Chiraggalav0024/moveo-robotic-arm/gallery/1.jpeg

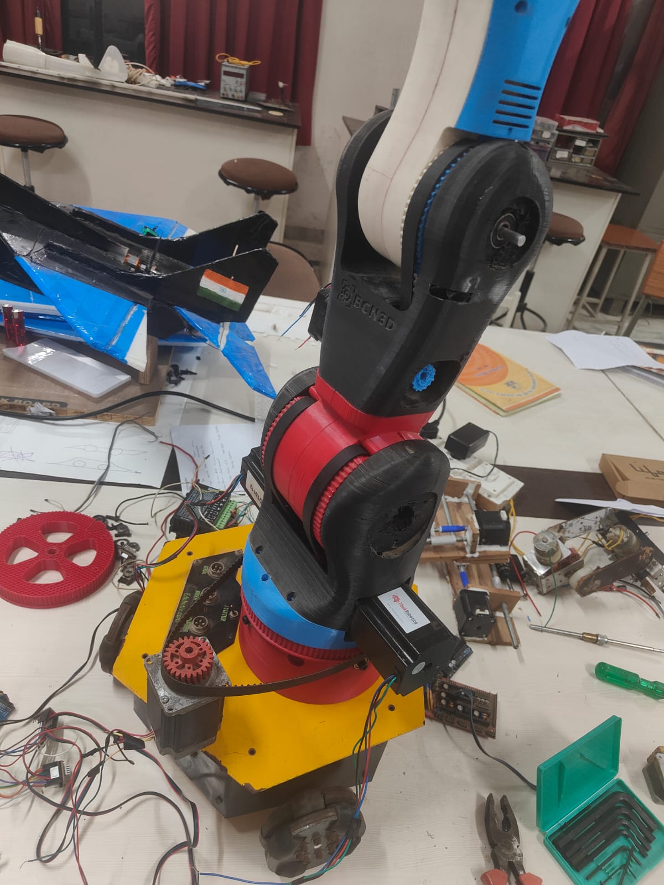
gallery/1.jpeg
