Chiraggalav0024/moveo-robotic-arm/gallery/2.jpeg

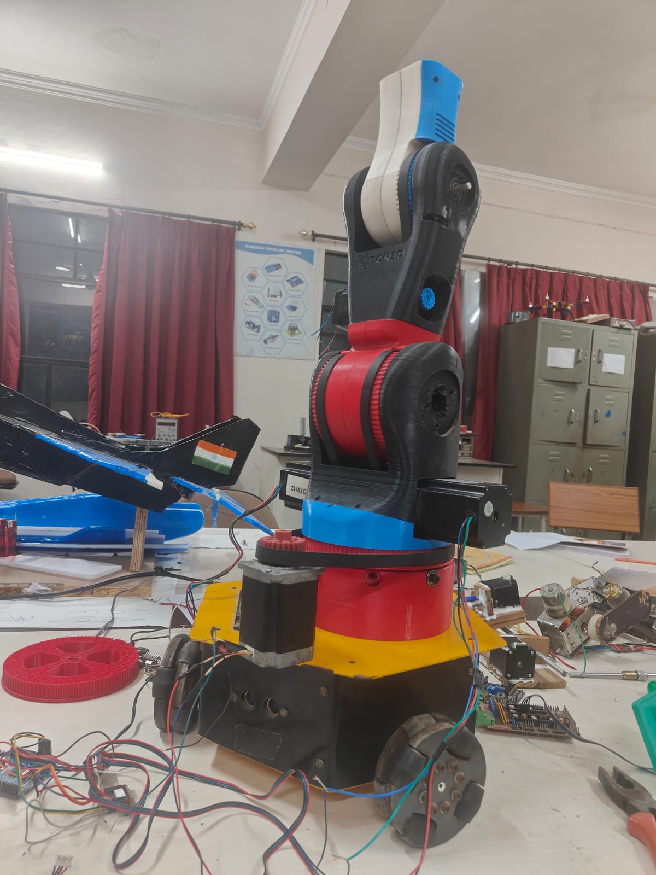
gallery/2.jpeg
