Chiraggalav0024/moveo-robotic-arm/README.md

# moveo-robotic-arm
A detailed report for this project is available as a PDF — it covers hardware assembly, wiring, firmware upload steps, controller and pairing setup.

📄 **[View Full Manual (PDF)](https://github.com/Chiraggalav0024/moveo-robotic-arm/blob/main/report.pdf)**
