Chiraggalav0024/moveo-robotic-arm/(commit log)

2026-03-10 Add ESP32 code for data transmission using ESP-NOw
2026-03-10 Add ESP8266 motor control with ESP-NOW communication
